Ulli2k/SmartCoffee/docs/NodeMCU-ESP8266-PINs-pinout.jpg

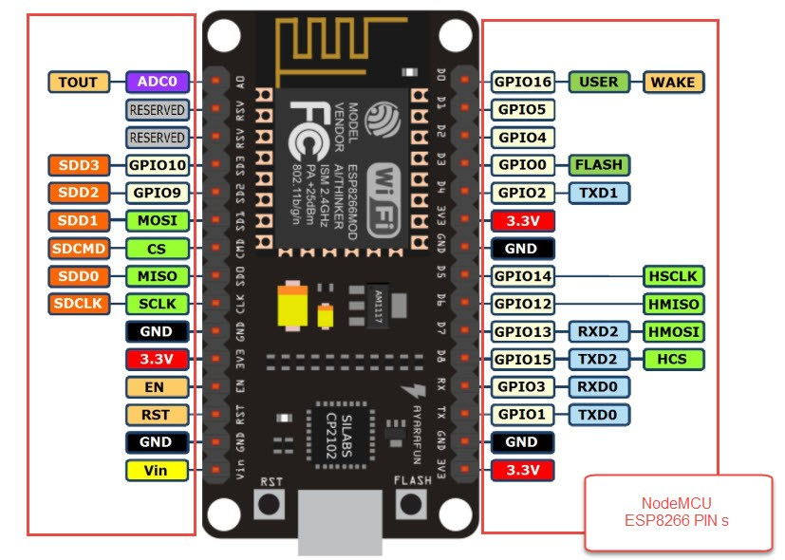
docs/NodeMCU-ESP8266-PINs-pinout.jpg
