Ulli2k/SmartCoffee/docs/Schaltplan-Silvia-E_PID.jpg

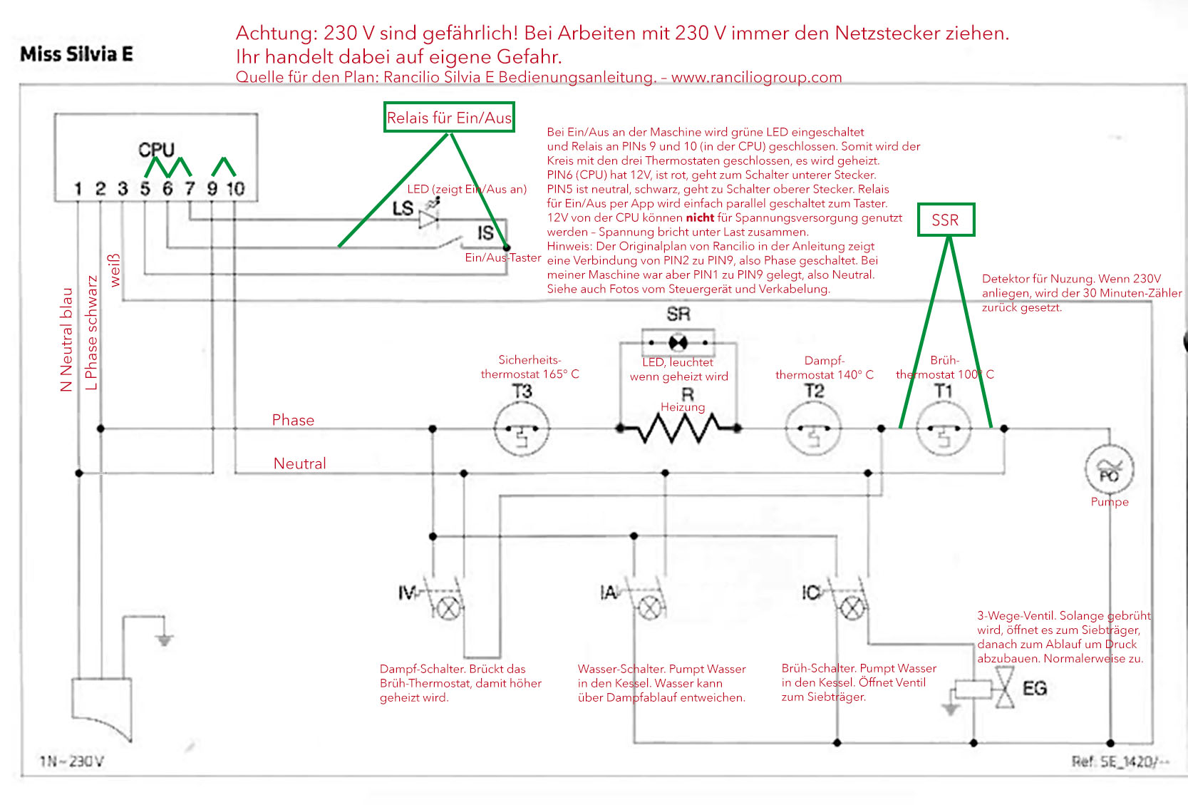
docs/Schaltplan-Silvia-E_PID.jpg
