Ulli2k/SmartCoffee/docs/BOM_SmartCoffee_reichelt.xlsx

BOM_SmartCoffee_reichelt
Part | Value | Device | Package | Description | REICHELT | LINK
C1 | 0.1µ | CAP0603-CAP | 0603-CAP | Capacitor | KEM Y5V0603 100N | https://www.reichelt.de/vielschicht-kerko-100nf-25v-85-c-kem-y5v0603-100n-p207005.html?&trstct=pol_1
C2 | 0.1µ | CAP0603-CAP | 0603-CAP | Capacitor | KEM Y5V0603 100N | https://www.reichelt.de/vielschicht-kerko-100nf-25v-85-c-kem-y5v0603-100n-p207005.html?&trstct=pol_1
C3 | 4.7µ | CAP0805-CAP | 0805-CAP | Capacitor | KEM X5R0603 4,7U | https://www.reichelt.de/vielschicht-kerko-4-7-f-10v-85-c-kem-x5r0603-4-7u-p207009.html?&trstct=pol_0
C4 | 0.1µ | CAP0603-CAP | 0603-CAP | Capacitor | KEM Y5V0603 100N | https://www.reichelt.de/vielschicht-kerko-100nf-25v-85-c-kem-y5v0603-100n-p207005.html?&trstct=pol_1
C5 | 0.1µ | CAP0603-CAP | 0603-CAP | Capacitor | KEM Y5V0603 100N | https://www.reichelt.de/vielschicht-kerko-100nf-25v-85-c-kem-y5v0603-100n-p207005.html?&trstct=pol_1
C6 | 0.1µ | CAP0603-CAP | 0603-CAP | Capacitor | KEM Y5V0603 100N | https://www.reichelt.de/vielschicht-kerko-100nf-25v-85-c-kem-y5v0603-100n-p207005.html?&trstct=pol_1
D1 | 1N4148W | DIODE-SOD123 | SOD123 | DIODE | RND 1N4148W | https://www.reichelt.de/schalt-diode-75-v-150-ma-sod-123-rnd-1n4148w-p223369.html
DISPLAY/ROTARY2 | PSS254_8GERADE | PSS254_8GERADE | 08G |  | PSS 254/8G | https://www.reichelt.de/printstecker-einzelstecker-gerade-8-polig-pss-254-8g-p14913.html
DS18B20 |  | PSS254_3GERADE | 03G |  | PSS 254/3G | https://www.reichelt.de/printstecker-einzelstecker-gerade-3-polig-pss-254-3g-p14462.html?trstct=pos_0
HEATER-SSR |  | PSS254_2GERADE | 02G |  | PSS 254/2G | https://www.reichelt.de/printstecker-einzelstecker-gerade-2-polig-pss-254-2g-p14907.html
HV_SUPPLY | 250-206 | 250-206 | P-250-206 | Serie 250, 1-Leiter-Klemmenleiste für Leiterplatten 1 Lötstift/Pol versetzt / Series 250, 1-conductor PCB terminal strip 1 solder pin/pole, staggeredPolzahl / Pole No.: 6 Rastermaß / Pitch: 3.5 - 3.5 mmBemessungsspannung / Rated Voltage: 320 VNennstrom / Nominal Current: 8 ALeiterquerschnitt / Conductor Size: 0.2 - 1.5 mm2Anschlusstechnik / Connection Technology: CAGE CLAMP® S Lötstiftlänge: / Solder Pin Length: 3.6 mmLeitereinführung (zur Platine) / Conductor entry angle (to PCB): 45 °Farbe / Color: grau / gray Stand: 01.01.2014. Die jeweils aktuellen Daten zu diesem Artikel finden Sie in unserem Produktkatalog, den Sie unter www.wago.com einsehen können. As of: 01/01/2014. Please find the newest data for this article in our product catalogue, which can be viewed under www.wago.com. | WAGO 250-206 | https://www.reichelt.de/klemmleiste-mit-betaetigungsdrueckern-rm-3-5-mm-8a-6-pol-wago-250-206-p100836.html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
IC1 | ULN2003V12DR | ULN2003AD | SO16 | DRIVER ARRAY | ULN 2003 AD SMD | https://www.reichelt.de/seven-darlington-arrays-so-16-uln-2003-ad-smd-p18887.html
K1 | G2R | G2RL-1 DC5 | G2R | RELAY | G2RL-1 DC5 | https://www.reichelt.de/leistungsrelais-tht-5-vdc-12a-1-wechsler-g2rl-1-dc5-p243108.html?trstct=pos_0
LED |  | PSS254_2GERADE | 02G |  | PSS 254/2G | https://www.reichelt.de/printstecker-einzelstecker-gerade-2-polig-pss-254-2g-p14907.html
LV_SUPPLY |  | PSS254_2GERADE | 02G |  | PSS 254/2G | https://www.reichelt.de/printstecker-einzelstecker-gerade-2-polig-pss-254-2g-p14907.html
OK1 | SFH620A | SFH620A | DIL04 | Optocoupler, Phototransistor Output, AC Input | SFH 620A-3 | https://www.reichelt.de/optokoppler-sfh-620a-3-p76195.html
ONOFF |  | PSS254_2GERADE | 02G |  | PSS 254/2G | https://www.reichelt.de/printstecker-einzelstecker-gerade-2-polig-pss-254-2g-p14907.html
PIEZO | BUZZER-PIEZO_SMD | BUZZER-PIEZO_SMD | BUZZER-PIEZO_SMD | Piezoelectric Acoustic Transducer
R1 | 4k7 | RESISTOR0603-RES | 0603-RES | Resistor | RND 1550603 BS | https://www.reichelt.de/smd-widerstand-0603-4-7-kohm-100-mw-5-rnd-1550603-bs-p250170.html?trstct=pol_2
R3 | 33 | RESISTOR0603-RES | 0603-RES | Resistor | RND 0603 1 33 | https://www.reichelt.de/smd-widerstand-0603-33-ohm-100-mw-1-rnd-0603-1-33-p183005.html?&trstct=pol_1
R4 | 22k | RESISTORUPRIGHT | RES_UPRIGHT | Resistor | 1W 22K | https://www.reichelt.de/widerstand-metalloxyd-22-kohm-0207-1-0-w-5-1w-22k-p1802.html?&trstct=pos_0
R5 | VARISTOR-S07K275 | VARISTOR-S07K275 | S07K275 | VARISTOR | VDR-0,25 420 | https://www.reichelt.de/varistor-rm-5mm-0-25w-420vac-vdr-0-25-420-p22313.html?&trstct=pol_0
R6 | 22k | RESISTORUPRIGHT | RES_UPRIGHT | Resistor | 1W 22K | https://www.reichelt.de/widerstand-metalloxyd-22-kohm-0207-1-0-w-5-1w-22k-p1802.html?&trstct=pos_0
R7 | 4k7 | RESISTOR0603-RES | 0603-RES | Resistor | RND 1550603 BS | https://www.reichelt.de/smd-widerstand-0603-4-7-kohm-100-mw-5-rnd-1550603-bs-p250170.html?trstct=pol_2
R8 | VARISTOR-S07K275 | VARISTOR-S07K275 | S07K275 | VARISTOR | VDR-0,25 420 | https://www.reichelt.de/varistor-rm-5mm-0-25w-420vac-vdr-0-25-420-p22313.html?&trstct=pol_0
R13 | 1k5 | RESISTOR0603-RES | 0603-RES | Resistor | RND 1550603 BM | https://www.reichelt.de/smd-widerstand-0603-1-5-kohm-100-mw-5-rnd-1550603-bm-p250164.html?trstct=pol_2
R16 | 1k5 | RESISTOR0603-RES | 0603-RES | Resistor | RND 1550603 BM | https://www.reichelt.de/smd-widerstand-0603-1-5-kohm-100-mw-5-rnd-1550603-bm-p250164.html?trstct=pol_2
R18 | 1k5 | RESISTOR0603-RES | 0603-RES | Resistor | RND 1550603 BM | https://www.reichelt.de/smd-widerstand-0603-1-5-kohm-100-mw-5-rnd-1550603-bm-p250164.html?trstct=pol_2
SUPPLY_SSR1 | OMRON-G3MB-202P-SSR | OMRON-G3MB-202P-SSR | OMRON-G3MB-202P-SSR | IT(rms) 8A, Zero Cross type SIP 4pin Triac output SSR
SUPPLY_SSR2 | OMRON-G3MB-202P-SSR | OMRON-G3MB-202P-SSR | OMRON-G3MB-202P-SSR | IT(rms) 8A, Zero Cross type SIP 4pin Triac output SSR
TSIC |  | PSS254_3GERADE | 03G |  | PSS 254/3G | https://www.reichelt.de/printstecker-einzelstecker-gerade-3-polig-pss-254-3g-p14462.html?trstct=pos_0
U$3 | ESP32DEVKITC | ESP32DEVKITC | ESP32-DEVKITC
