Ulli2k/SmartCoffee/docs/BOM.ods

PCB Klebepads
Silikonkabel oder PTFE Kabel für Temperatursensor |  |  | https://www.buerklin.com/de/Produkte/Kabel-und-Leitungen/Mehradrige-Kabel-und-Leitungen/Anschlussleitungen%2C-Steuerleitungen-und-Industrieleitungen/Anschluss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
TSIC306 – Temperatursensor |  |  | reichelt
OMRON SSR für Pumpe |  |  | 1 A instant-on type
OMRON SSR für 3 Wege Ventil
SENS für Pumpe (Optokoppler |  | SFH620A | Opto-isolated 48-240V~ sense input (zero crossing detection for phase angle control)
Kabel für Pumpe 1mm²
Signalkabel 0,25mm²
Leistungs SSR
Flachkontakte für Leistungsseite von SSR |  |  | 6.4mm Flachsteckhülsen (FASTON) terminals als Kabel?
Netzteil (230V, 5V mit >= 600mA) | Artikel-Nr.: SNT RS 15 5
Fuse ESKA t2A 250V
Wärmeleitpaste / Kleber
ONOFF Relais
Info
Vibrationspumpe (Wasser) |  | 230V, 50Hz, 48 W
 |  |  |  | 53D1659
Schaltersensor
Pro Platine | Reichelt
2 x 22KΩ 1W 1W 22K - Widerstand, Metalloxyd, 22 kOhm, 0207, 1,0 W, 5% (https://www.reichelt.de/widerstand-metalloxyd-22-kohm-0207-1-0-w-5-1w-22k-p1802.html?) | Artikel-Nr.: 1W 22K
1x SFH SFH 620A-3 - Optokoppler (https://www.reichelt.de/optokoppler-sfh-620a-3-p76195.html?) | Artikel-Nr.: SFH 620A-3
1x 4,7 oder 10µF RAD FC 4,7/50 - Elko radial, 4,7 uF, 50 V, 105°C, low ESR, AEC-Q200 (https://www.reichelt.de/elko-radial-4-7-uf-50-v-105-c-low-esr-aec-q200-rad-fc-4-7-50-p84583.html?) | RAD FC 4,7/50
1x 2KΩ Widerstand
1x Printstecker Gewinkelt PSS 254/3W - Printstecker, Einzelstecker, gewinkelt, 3-polig (https://www.reichelt.de/printstecker-einzelstecker-gewinkelt-3-polig-pss-254-3w-p14910.html?) | Artikel-Nr.: PSS 254/3W
ESP8266
GPIOs 4 and 5 are the only ones that are always high impedance. All others do have internal pull-ups or are even driven low/high during boot.
GPIOs 3, 12, 13 and 14 pulled HIGH during boot. Their actual state does not influence the boot process.
GPIOs 0, 1, 2 and 15 are pulled HIGH during boot and also driven LOW for short periods.
The device will not boot if 0, 1 or 2 is driven LOW during start-up.
GPIO 16 is driven HIGH during boot, don't short to GND.
