Ulli2k/SmartCoffee/hardware/SmartCoffee_InterfaceName.pdf

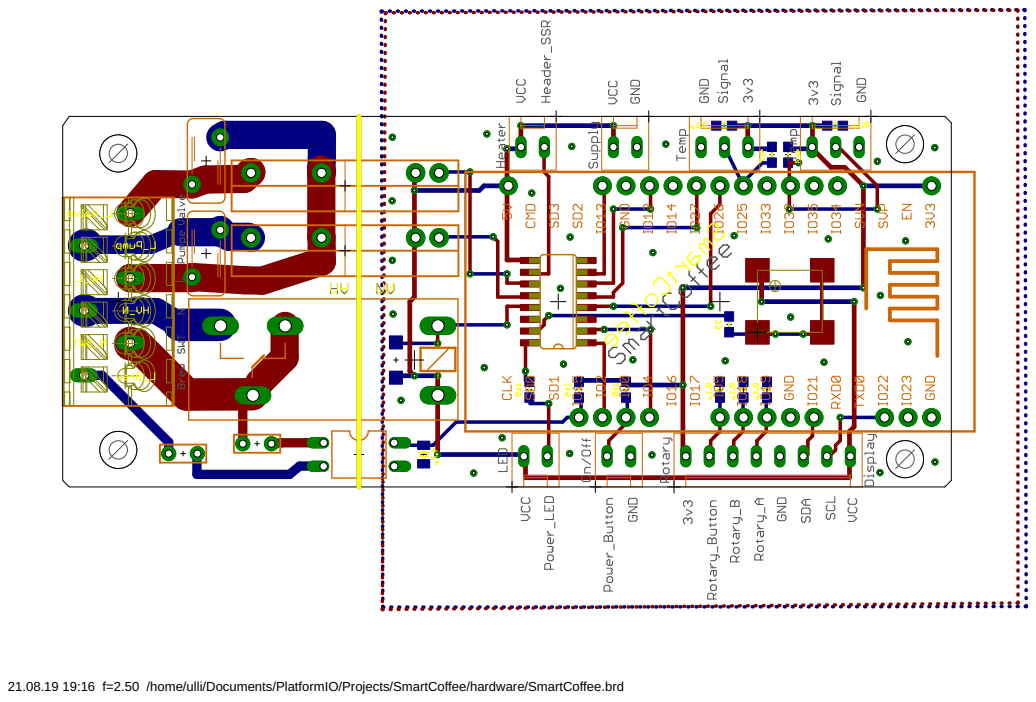
[picture p3: page 1]

21.08.19 19:16 f=2.50 /home/ulli/Documents/PlatformIO/Projects/SmartCoffee/hardware/SmartCoffee.brd
