Ulli2k/SmartCoffee/hardware/SmartCoffee.pdf

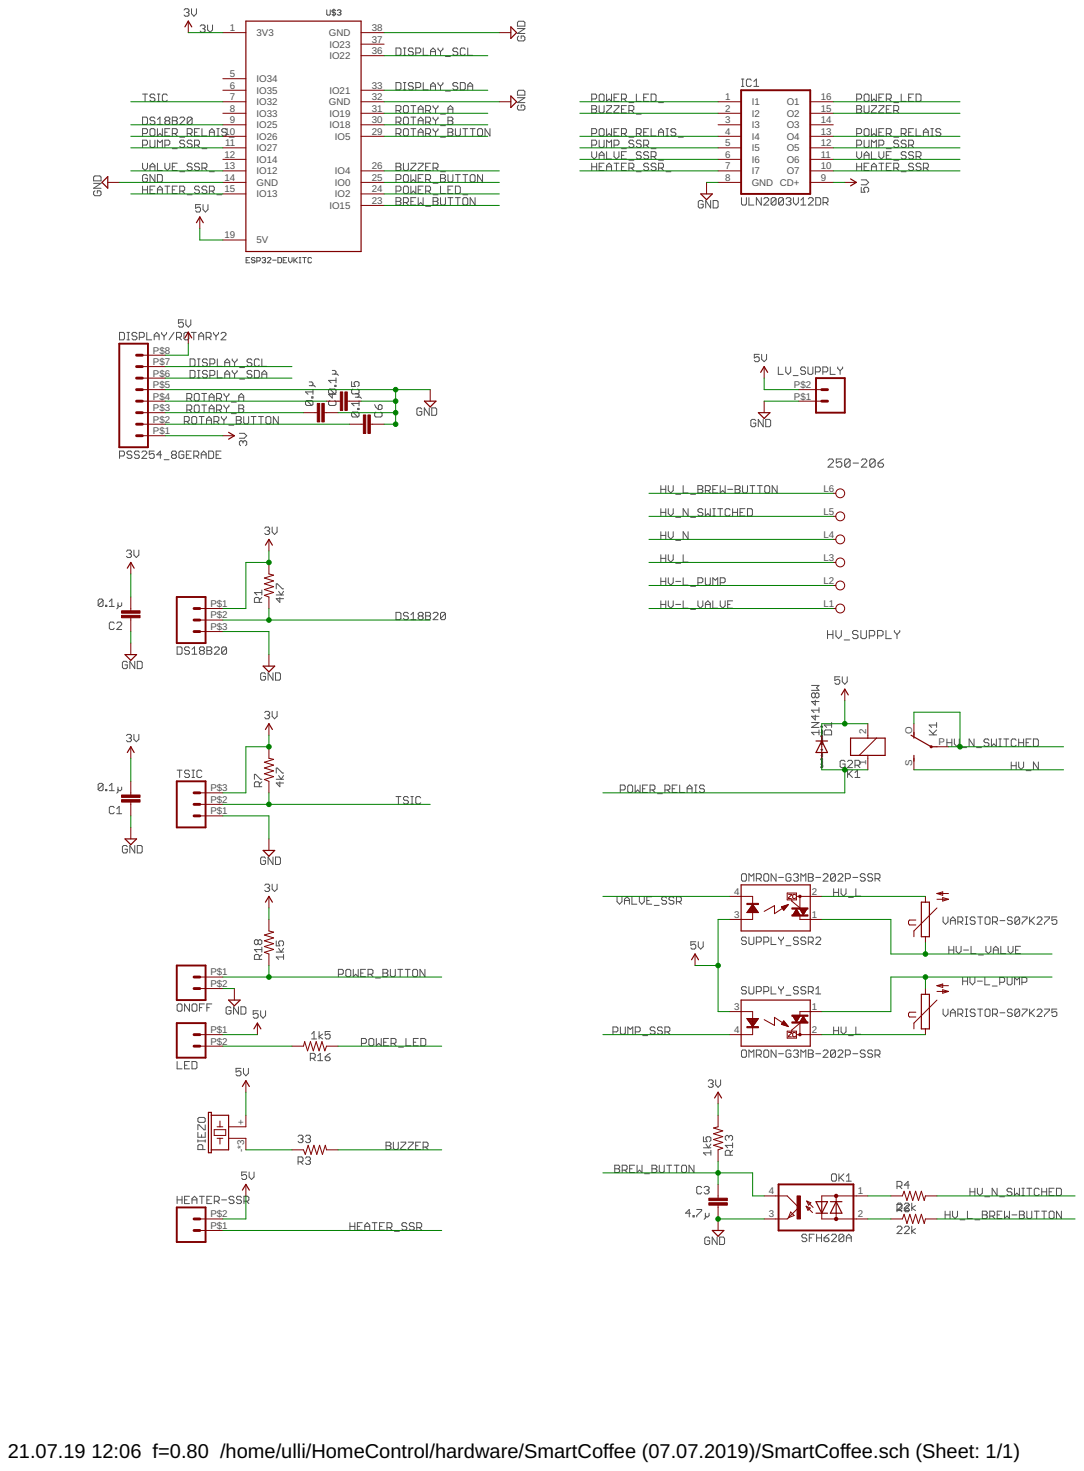
[picture p4: page 1]

21.07.19 12:06 f=0.80 /home/ulli/HomeControl/hardware/SmartCoffee (07.07.2019)/SmartCoffee.sch (Sheet: 1/1)
