Ulli2k/SmartCoffee/hardware/SmartCoffee.brd

## EAGLE design hardware/SmartCoffee.brd (2019-08-21)

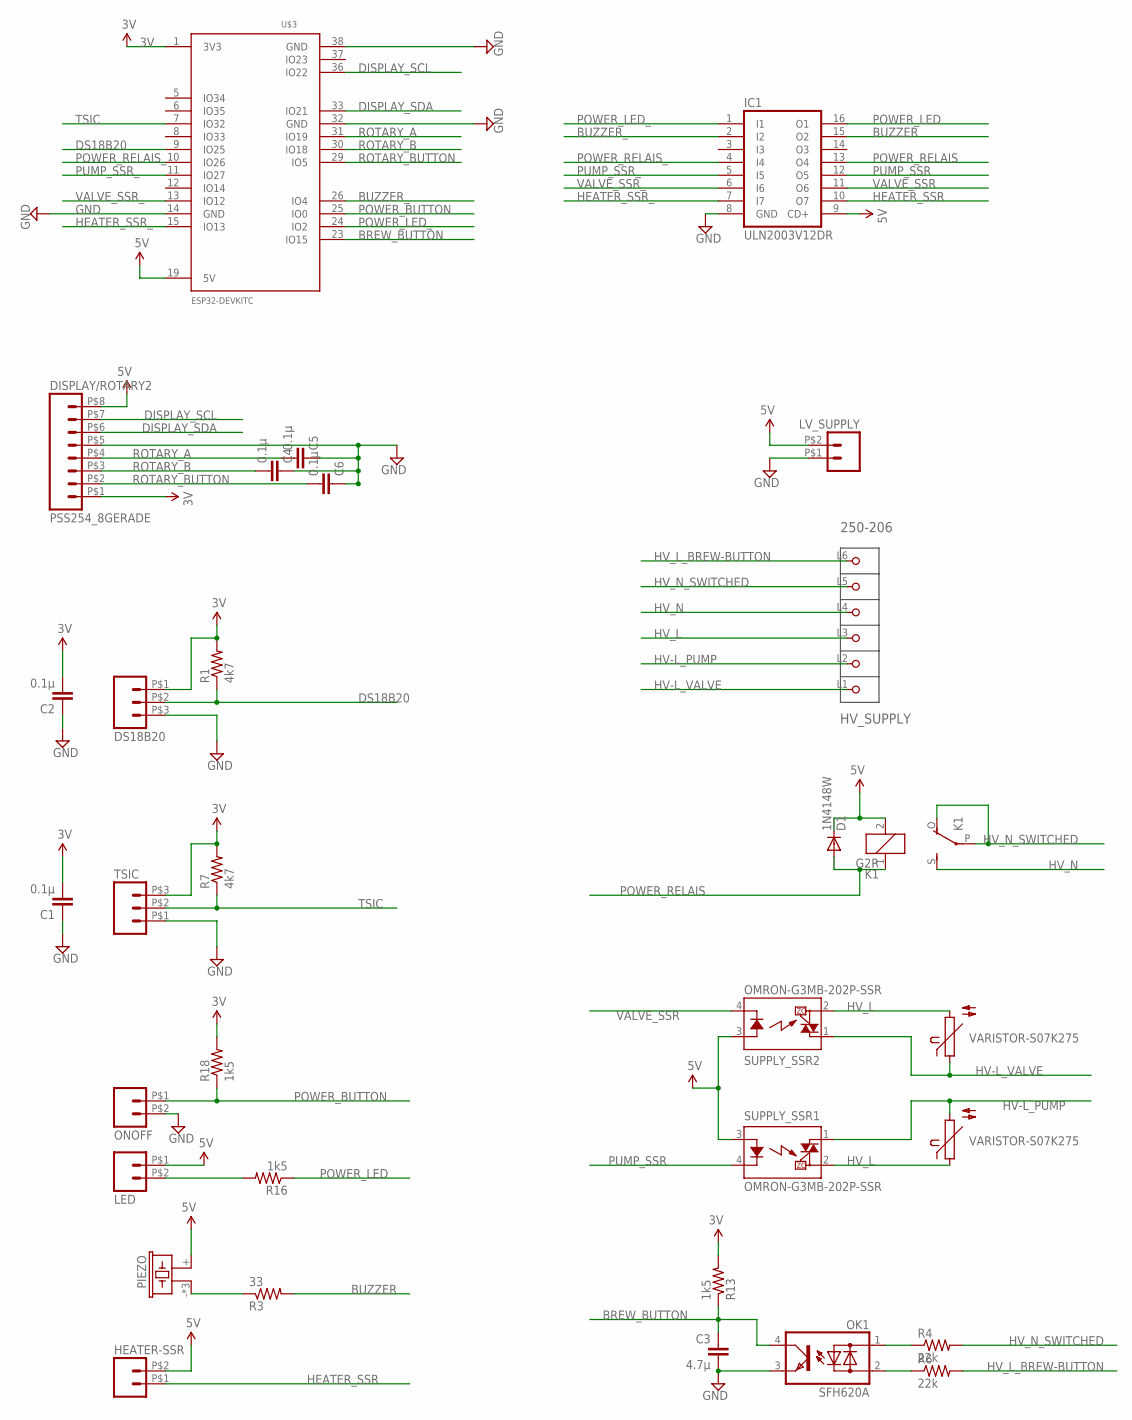
[picture p5: schematic SmartCoffee.sch]

Parts:
C1, C2, C4, C5, C6: 0.1µ; 0603-CAP
C3: 4.7µ; 0805-CAP
D1: 1N4148W; SOD123
DISPLAY/ROTARY2: PSS254_8GERADE; 08G
DS18B20: PSS254_3GERADE; 03G
HEATER-SSR: PSS254_2GERADE; 02G
HV_SUPPLY: 250-206; P-250-206
IC1: ULN2003V12DR; SO16
K1: G2R
LED: PSS254_2GERADE; 02G
LV_SUPPLY: PSS254_2GERADE; 02G
OK1: SFH620A; DIL04
ONOFF: PSS254_2GERADE; 02G
PIEZO: BUZZER-PIEZO_SMD
R1, R7: 4k7; 0603-RES
R3: 33; 0603-RES
R4, R6: 22k; RES_UPRIGHT
R5, R8: VARISTOR-S07K275; S07K275
R13, R16, R18: 1k5; 0603-RES
SUPPLY_SSR1, SUPPLY_SSR2: OMRON-G3MB-202P-SSR
TSIC: PSS254_3GERADE; 03G
U$3: ESP32DEVKITC; ESP32-DEVKITC

Connections:
3V: C1.2, C2.2, DISPLAY/ROTARY2.P$1 (1), DS18B20.P$1 (1), R1.2, R7.2, R13.2, R18.2, TSIC.P$3 (3), U$3.1 (3V3)
BREW_BUTTON: C3.1, OK1.4 (C), R13.1, U$3.23 (IO15)
BUZZER: IC1.15 (O2), R3.2
BUZZER_: IC1.2 (I2), U$3.26 (IO4)
DISPLAY_SCL: DISPLAY/ROTARY2.P$7 (7), U$3.36 (IO22)
DISPLAY_SDA: DISPLAY/ROTARY2.P$6 (6), U$3.33 (IO21)
DS18B20: DS18B20.P$2 (2), R1.1, U$3.9 (IO25)
GND: C1.1, C2.1, C3.2, C4.1, C5.1, C6.1, DISPLAY/ROTARY2.P$5 (5), DS18B20.P$3 (3), IC1.8 (GND), LV_SUPPLY.P$1 (1), OK1.3 (E), ONOFF.P$2 (2), TSIC.P$1 (1), U$3.14 (GND), U$3.32 (GND), U$3.38 (GND)
HEATER_SSR: HEATER-SSR.P$1 (1), IC1.10 (O7)
HEATER_SSR_: IC1.7 (I7), U$3.15 (IO13)
HV-L_PUMP: HV_SUPPLY.L2 (P2), R8.2, SUPPLY_SSR1.1 (DS1)
HV-L_VALVE: HV_SUPPLY.L1 (P1), R5.1, SUPPLY_SSR2.1 (DS1)
HV_L: HV_SUPPLY.L3 (P3), R5.2, R8.1, SUPPLY_SSR1.2 (DS2), SUPPLY_SSR2.2 (DS2)
HV_L_BREW-BUTTON: HV_SUPPLY.L6 (P6), R6.2
HV_N: HV_SUPPLY.L4 (P4), K1.S
HV_N_SWITCHED: HV_SUPPLY.L5 (P5), K1.O, K1.P, R4.2
unnamed: LED.P$2 (2), R16.2
unnamed: OK1.1 (AC1), R4.1
unnamed: PIEZO.- (2), PIEZO.DUMMY (2), PIEZO.DUMMY1 (2), R3.1
unnamed: OK1.2 (AC2), R6.1
POWER_BUTTON: ONOFF.P$1 (1), R18.1, U$3.25 (IO0)
POWER_LED: IC1.16 (O1), R16.1
POWER_LED_: IC1.1 (I1), U$3.24 (IO2)
POWER_RELAIS: D1.A, IC1.13 (O4), K1.1
POWER_RELAIS_: IC1.4 (I4), U$3.10 (IO26)
PUMP_SSR: IC1.12 (O5), SUPPLY_SSR1.4 (K)
PUMP_SSR_: IC1.5 (I5), U$3.11 (IO27)
ROTARY_A: C5.2, DISPLAY/ROTARY2.P$4 (4), U$3.31 (IO19)
ROTARY_B: C4.2, DISPLAY/ROTARY2.P$3 (3), U$3.30 (IO18)
ROTARY_BUTTON: C6.2, DISPLAY/ROTARY2.P$2 (2), U$3.29 (IO5)
TSIC: R7.1, TSIC.P$2 (2), U$3.7 (IO32)
VALVE_SSR: IC1.11 (O6), SUPPLY_SSR2.4 (K)
VALVE_SSR_: IC1.6 (I6), U$3.13 (IO12)
VCC: D1.C, DISPLAY/ROTARY2.P$8 (8), HEATER-SSR.P$2 (2), IC1.9 (CD+), K1.2, LED.P$1 (1), LV_SUPPLY.P$2 (2), PIEZO.+ (1), SUPPLY_SSR1.3 (A), SUPPLY_SSR2.3 (A), U$3.19 (5V)

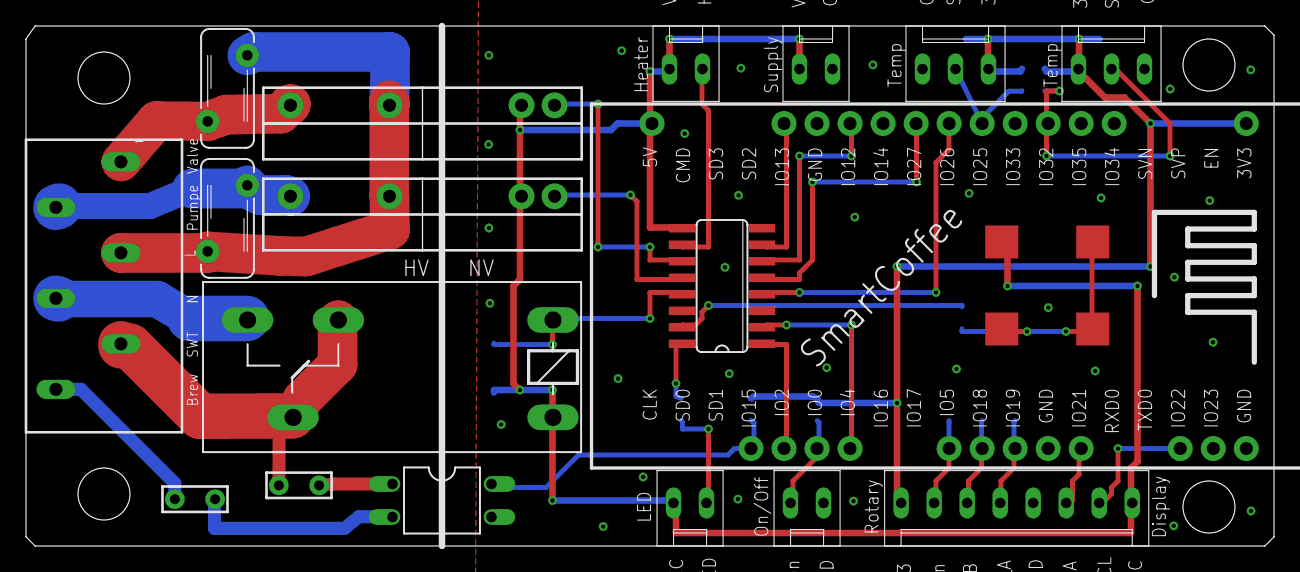
[picture p6: board SmartCoffee.brd from above]

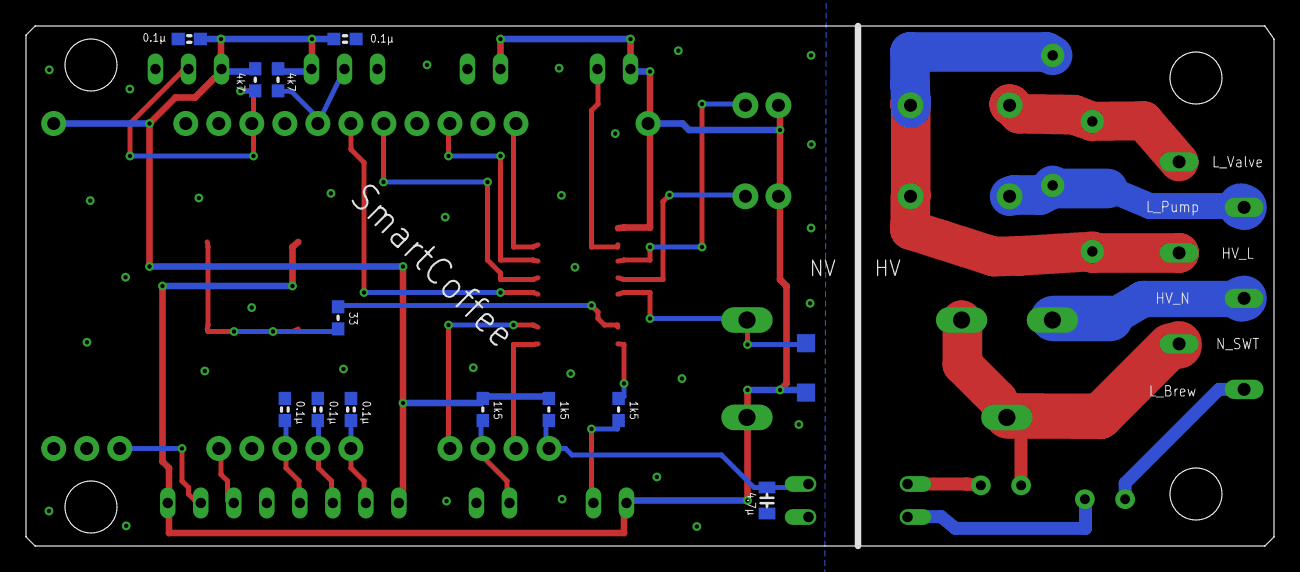
[picture p7: board SmartCoffee.brd from below]

Board: 2 copper layers, 96.0 x 40.0 mm, 32 parts (13 on the bottom side), 34 nets.
