Ulli2k/SmartCoffee/include/interface.h

#ifndef __MENU_H__
#define __MENU_H__

#ifdef HAS_INTERFACE

#include <globals.h>
#include <encoder.h>
#include <display.h>

#include <menu.h>//menu macros and objects
#include <menuIO/u8g2Out.h>
#include <menuIO/clickEncoderIn.h>
#include <menuIO/chainStream.h>

namespace UserInterface {
  using namespace Menu;

  result cleaning(eventMask e,navNode& nav, prompt &item);
  result exitMenu(eventMask e, navNode& nav, prompt &item);

  // ------------------- MENU ----------------------
  #define MAX_DEPTH 2

  const colorDef<uint8_t> colors[] MEMMODE={ //  {{disabled normal,disabled selected},{enabled normal,enabled selected, enabled editing}}
    {{0,0},{0,1,0}},//bgColor
    {{0,0},{1,1,1}},//fgColor
    {{1,1},{1,0,0}},//valColor
    {{1,1},{1,0,0}},//unitColor
    {{0,0},{0,0,1}},//cursorColor
    {{1,1},{1,0,0}},//titleColor
    // {{0,0},{0,1,1}},//bgColor
    // {{1,1},{1,0,0}},//fgColor
    // {{1,1},{1,0,0}},//valColor
    // {{1,1},{1,0,0}},//unitColor
    // {{0,1},{0,0,1}},//cursorColor
    // {{1,1},{1,0,0}},//titleColor
  };

  MENU(subMenu_TempCtl,"TempControl    ",doNothing,anyEvent,noStyle
    ,FIELD(globalValues.TempSetValue,                     "Temperature ","C",0,100,1,0,doNothing,noEvent,wrapStyle)
    ,FIELD(configValues.stateMaschine.TempMinError,       "TempThreshold  ","C",0,20,1,0,doNothing,noEvent,wrapStyle)
    ,FIELD(configValues.stateMaschine.TempStabilizingTime,"TempStabilize ","s",0,200,1,0,doNothing,noEvent,wrapStyle)
    ,FIELD(configValues.PID.consKp,                       "Kp         "," ",0,300,1,1,doNothing,noEvent,wrapStyle)
    ,FIELD(configValues.PID.consKi,                       "Ki          "," ",0,10,0.1,0.01,doNothing,noEvent,wrapStyle)
    ,FIELD(configValues.PID.consKd,                       "Kd          "," ",0,10,0.1,0.01,doNothing,noEvent,wrapStyle)
    ,FIELD(configValues.PID.Gap4BoostParameter,           "boostGap      "," ",0,50,1,1,doNothing,noEvent,wrapStyle)
    ,FIELD(configValues.PID.boostKp,                      "boostKp   "," ",0,300,1,1,doNothing,noEvent,wrapStyle)
    ,FIELD(configValues.PID.boostKi,                      "boostKi     "," ",0,10,0.1,0.01,doNothing,noEvent,wrapStyle)
    ,FIELD(configValues.PID.boostKd,                      "boostKd     "," ",0,10,0.1,0.01,doNothing,noEvent,wrapStyle)
    ,EXIT("<Back")
  );

  MENU(subMenu_Preinfusion,"Preinfusion    ",doNothing,anyEvent,noStyle
    ,FIELD(configValues.stateMaschine.Preinfusion_Duration,     "Preinfusion ","s",0,60,1,0.1,doNothing,noEvent,wrapStyle)
    ,FIELD(configValues.stateMaschine.Preinfusion_PumpDuration, "Preinf.Pump ","s",0,10,1,0.1,doNothing,noEvent,wrapStyle)
    ,EXIT("<Back")
  );

  MENU(subMenu_Brewing,"Brewing        ",doNothing,anyEvent,noStyle
    ,FIELD(configValues.stateMaschine.Brewing_Duration,             "Brewing    ","s",0,60,1,0.1,doNothing,noEvent,wrapStyle)
    ,FIELD(configValues.stateMaschine.BrewingTempSetpointIncrease,  "BrewingInc    ","C",0,100,1,0,doNothing,noEvent,wrapStyle)
    ,FIELD(configValues.stateMaschine.Flush_Duration,               "Flush       ","s",0,20,1,0.1,doNothing,noEvent,wrapStyle)
    ,EXIT("<Back")
  );

  MENU(subMenu_Cleaning,"Cleaning       ",doNothing,anyEvent,noStyle
    ,OP("Start Cleaning ",cleaning,enterEvent)
    ,FIELD(configValues.stateMaschine.Cleaning_WaitDuration,  "CleanWait  ","s",1,120,1,0,doNothing,noEvent,wrapStyle)
    ,FIELD(configValues.stateMaschine.Cleaning_FlushDuration, "CleanFlush  ","s",1,10,1,0.1,doNothing,noEvent,wrapStyle)
    ,FIELD(configValues.stateMaschine.Cleaning_NumFlushes,    "CleanFlushNum  ","",1,10,1,0,doNothing,noEvent,wrapStyle)
    ,EXIT("<Back")
  );

  MENU(mainMenu,"Configuration",doNothing,noEvent,noStyle
    ,SUBMENU(subMenu_TempCtl)
    ,SUBMENU(subMenu_Preinfusion)
    ,SUBMENU(subMenu_Brewing)
    ,SUBMENU(subMenu_Cleaning)
    ,FIELD(configValues.stateMaschine.MaxPowerOnTime, "MaxPowerOn  ","min",1,120,10,5,doNothing,noEvent,wrapStyle)
    ,OP("reboot         ",rebootESP,enterEvent)
    ,OP("save config    ",saveConfiguration,enterEvent)
    ,OP("reset config   ",removeConfiguration,enterEvent)
    ,OP("<Back          ", exitMenu,enterEvent)
  );

  ClickEncoderStream encStream(cEncoder.encoder,1);
  MENU_INPUTS(in,&encStream);
  MENU_OUTPUTS(out,MAX_DEPTH
    // ,U8X8_OUT(u8x8,{0,1,10,6})
    ,U8G2_OUT(cDisplay.u8g2,colors,cDisplay.fontX,cDisplay.fontY, 0, /* Headersize*/ 2 /*cDisplay.fontY+3*/ ,{0,1,cDisplay.width/cDisplay.fontX,cDisplay.height/cDisplay.fontY-1})
    ,NONE
  );
  NAVROOT(nav,mainMenu,MAX_DEPTH,in,out);//the navigation root object


/****************************************** Interface Class ******************************************/

  #define DRAW(CMD) { cDisplay.firstPage(); do { CMD; } while(cDisplay.nextPage()); }

  #define GET_CENTER_POSITION_X(STR) ((cDisplay.width-cDisplay.u8g2.getStrWidth(STR))/2)
  #define GET_FONT_WIDTH(STR)        (cDisplay.u8g2.getStrWidth(STR))

  enum InterfaceScreen {
    CONFIG=0,
    STANDBY,
    TEXT,
    VALUE
  };

// #define convertEvents(label) (InterfaceEvent::#label);

  typedef struct {
    char header[20];
    double *value;
    char text[20];
    char valueUnit[5];
    double *setpoint;
    double *percent;
    bool setpointEditMode;

  } draw_ScreenValues;

  class ScreenTypes {

  private:

    void drawHeader(char *name) {
      cDisplay.setFontSize();
      cDisplay.u8g2.drawStr(0,cDisplay.fontY, name);
      cDisplay.u8g2.drawHLine(0,cDisplay.fontY+1,128);
    }

    void drawSetPoint(double *setpoint, bool *editMode) {
      if(!setpoint) return;
      cDisplay.setFontSize();
      char str[6];
      uint8_t i = (uint8_t)(*setpoint);
      if(editMode != NULL && *editMode) {
        sprintf(str, (i>9 ? ">%d" : "> %d"), i);
      } else {
        sprintf(str, (i>9 ? "%d" : " %d"), i);
      }
      cDisplay.u8g2.drawStr(cDisplay.width-GET_FONT_WIDTH(str) , cDisplay.fontY, str);
    }

    void drawProgressBar(double *percent, uint8_t x, uint8_t y, uint8_t h) {
      if(!percent) return;
      cDisplay.setFontSize();
      cDisplay.u8g2.drawFrame(x, y, cDisplay.width-(x*2), h); \
      cDisplay.u8g2.drawBox(x+2, y+2, (uint8_t)((cDisplay.width-(x*2)-4) * (*percent)), h-4);
    }

    void drawMainValue(double *value, char *unit, uint8_t y) {
      if(!value) return;
      cDisplay.setFontSize();
      char str[5];
      uint8_t u = 0;
      if(unit) u = GET_FONT_WIDTH(unit);
      cDisplay.setFontSize(3);
      uint8_t v = (uint8_t)(*value);
      sprintf(str, (v>9 ? "%d" : " %d"), v);
      v = GET_FONT_WIDTH(str);
      v += 2; //Abstand
      cDisplay.u8g2.drawStr( (cDisplay.width-(u+v))/2 , y, str);
      if(unit) {
        cDisplay.setFontSize();
        cDisplay.u8g2.drawStr( (cDisplay.width-(u+v))/2+v/*Abstand*/ , y, unit);
      }
    }

    void drawMainText(char *text, uint8_t y) {
      cDisplay.setFontSize(3);
      uint8_t v = GET_FONT_WIDTH(text);
      cDisplay.u8g2.drawStr( (cDisplay.width-(v))/2 , y, text);
    }

    void drawText(char *text, uint8_t y) {
      cDisplay.setFontSize();
      uint8_t v = GET_FONT_WIDTH(text);
      cDisplay.u8g2.drawStr( (cDisplay.width-(v))/2 , y, text);
    }

  public:
    draw_ScreenValues drawValues;

    ScreenTypes() { clear(); }

    void clear() {
      drawValues.header[0]        = 0x0;
      drawValues.value            = NULL;
      drawValues.text[0]          = 0x0;
      drawValues.valueUnit[0]     = 0x0;
      drawValues.setpoint         = NULL;
      drawValues.setpointEditMode = false;
      drawValues.percent          = NULL;
      // drawValues.lastUpdate       = 0;
      // drawValues.UpdateInterval   = DEFAULT_UPDATE_INTERVAL;
    }

    void drawTextScreen() {
      if(!drawValues.header[0]) return;
      drawHeader(drawValues.header);

      drawText(drawValues.text, cDisplay.height - 17);
    }

    void drawValueScreen() {
      
      if(!drawValues.header[0]) return;
      drawHeader(drawValues.header);

      drawSetPoint(drawValues.setpoint, &drawValues.setpointEditMode);

      drawProgressBar(drawValues.percent,0,cDisplay.height-10,10);

      drawMainValue(drawValues.value, drawValues.valueUnit, cDisplay.height - 17);

    }

    void drawConfigScreen() {
      drawHeader("Configuration");
      nav.doOutput();
    }

    void drawDateTimeScreen() {
      char buffer[12]; //dd.mm.yyyy & hh:mm
      const char *days[] = {"So", "Mo", "Di", "Mi", "Do", "Fr", "Sa"};

      drawHeader(drawValues.header);

      sprintf(buffer,"%.2d:%.2d",globalValues.TimeDate.hour, globalValues.TimeDate.min);
      drawMainText(buffer,cDisplay.height-17);

      sprintf(buffer,"%s, %.2d.%.2d",days[globalValues.TimeDate.wday], globalValues.TimeDate.day,globalValues.TimeDate.month);
      drawText(buffer,cDisplay.height);

      globalValues.TimeDate.updated = false;
    }
  };

  class ClassMenu : public ScreenTypes {

  private:
    InterfaceScreen screen;

  public:
	  ClassMenu()  {}
    static MenuFunctions ConfigMenuFkt;
    static bool forceUpdateScreen;

  	void initialize() {
      cDisplay.initialize();
      activateTextScreen("Servus!","booting...");flush();
      cEncoder.initialize();

      // nav.idleTask=idle;//point a function to be used when menu is suspended
      // mainMenu[1].enabled=disabledStatus;
      nav.showTitle=false;
      // nav.idleTask=idle;//point a function to be used when menu is suspended
      screen = CONFIG;
      forceUpdateScreen = true;
      ConfigMenuFkt = NOTHING;
    }

    void flush() {
      switch(screen) {
        case CONFIG:
          if (nav.changed(0) || forceUpdateScreen) {//only draw if menu changed for gfx device
            //change checking leaves more time for other tasks
            DRAW( drawConfigScreen(); )
          }
        break;

        case STANDBY:
          if(globalValues.TimeDate.updated || forceUpdateScreen) {
            DRAW( drawDateTimeScreen(); )
          }
        break;

        case TEXT:
          DRAW( drawTextScreen(); )
        break;

        case VALUE:
          DRAW( drawValueScreen(); )
        break;
      }
    }

    MenuFunctions getMenuFunction(EncoderEvent EncRetVal) {
      switch(EncRetVal) {
        case ENC_NOTHING:
          return NOTHING;
        case ENC_BUTTON_PRESSED:
          return BUTTON_PRESSED;
        case ENC_BUTTON_HELD:
          return BUTTON_HELD;
        case ENC_ROTATE_LEFT:
          return ROTATE_LEFT;
        case ENC_ROTATE_RIGHT:
          return ROTATE_RIGHT;
        }
        return NOTHING;
    }

    enum MenuFunctions poll() {

      MenuFunctions retVal = NOTHING;

      if(ConfigMenuFkt) {
        retVal = ConfigMenuFkt;
        ConfigMenuFkt = NOTHING;
        return retVal;
      }

      switch(screen) {
        case CONFIG:
          nav.doInput();
          break;

        case STANDBY:
          // break;
        case TEXT:
          retVal = getMenuFunction(cEncoder.poll());
          if(retVal == BUTTON_HELD) {
            activateConfigScreen();
            return BUTTON_HELD;
          }
          break;

        case VALUE:
          if(retVal = getMenuFunction(cEncoder.poll())) {
            if(retVal == BUTTON_HELD) {
              activateConfigScreen();
              return BUTTON_HELD;
            }
            if(drawValues.setpoint) {
              switch(retVal) {
                case BUTTON_PRESSED:
                  drawValues.setpointEditMode = !drawValues.setpointEditMode;
                  break;
                case ROTATE_LEFT:
                  if(drawValues.setpointEditMode)
                    (*drawValues.setpoint)++;
                  break;
                case ROTATE_RIGHT:
                  if(drawValues.setpointEditMode)
                    (*drawValues.setpoint)--;
                  break;
              }
            }
            return retVal;
          }
          break;
      }

      flush();

      if(retVal != NOTHING) forceUpdateScreen = false;
      return retVal;
    }

    void changeScreen(InterfaceScreen s) {
      screen = s;
      forceUpdateScreen = true;
    }

    void activateTextScreen(const char* header, const char *text) {
      clear();
      strcpy(drawValues.header,header);
      strcpy(drawValues.text,text);
      changeScreen(TEXT);
    }

    void activateValueScreen(const char* header, double *value = NULL, const char *unit = NULL, double *setpoint = NULL, double *percent = NULL) {
      clear();
      strcpy(drawValues.header,header);
      drawValues.value = value;
      if(unit) {
        strcpy(drawValues.valueUnit,unit);
      }
      drawValues.setpoint = setpoint;
      drawValues.percent = percent;
      changeScreen(VALUE);
    }

    void activateConfigScreen() {
      changeScreen(CONFIG);
    }

    void activateStandbyScreen(const char* header) {
      clear();
      strcpy(drawValues.header,header);
      changeScreen(STANDBY);
    }
  };


  result showEvent(eventMask e,navNode& nav,prompt& item) {
    Serial.print("event: ");
    Serial.println(e);
    return proceed;
  }

  result cleaning(eventMask e, navNode& nav, prompt &item) {
    ClassMenu::ConfigMenuFkt = FKT_CLEANING;
    return proceed;
  }

  result exitMenu(eventMask e, navNode& nav, prompt &item) {
    ClassMenu::ConfigMenuFkt = EXIT;
    ClassMenu::forceUpdateScreen = true;
    return proceed;
  }

  MenuFunctions ClassMenu::ConfigMenuFkt = NOTHING; //static variable
  bool ClassMenu::forceUpdateScreen = true;
}

#else

#include <encoder.h>

namespace UserInterface {

class noClassMenu {
public:
  void initialize() { }
  enum EncoderEvent poll() {}
  void flush() {}
  void activateTextScreen(const char* header, char *text) { }
  void activateValueScreen(const char* header, double *value = NULL, const char *unit = NULL, double *setpoint = NULL, double *percent = NULL) { }
  void activateConfigScreen() {}
};
}

#endif

#endif
