Ulli2k/SmartCoffee/include/globals.h

#ifndef __GLOBALS_H__
#define __GLOBALS_H__

//==============================================================
//                  Global Values
//==============================================================

enum MenuFunctions {
  NOTHING = 0,
  BUTTON_PRESSED,
  BUTTON_HELD,
  ROTATE_LEFT,
  ROTATE_RIGHT,
  FKT_CLEANING,
  EXIT
};

struct structGlobalValues{
  bool standby;
  double TempSetValue; //PID SetPoint
  // bool   SetPointEditMode;
  // bool PIDactive;
  double TempValue;    //PID Input
  double Pid_Percent;  //PID OutPut in percent
  struct {
    uint8_t hour;
    uint8_t min;
    uint8_t wday;
    uint8_t day;
    uint8_t month;
    bool updated;
  } TimeDate;
} globalValues;

#define EEPROM_KEY    945487320 //4 bytes
struct structConfigValues {
  unsigned int key;
  double TempSetValue; //PID SetPoint

  struct {
    double  consKp;
    double  consKi;
    double  consKd;
    uint8_t Gap4BoostParameter;
    double  boostKp;
    double  boostKi;
    double  boostKd;
  } PID;

  struct {
    uint8_t   MaxPowerOnTime;
    uint8_t   TempMinError;
    uint8_t   TempStabilizingTime;
    double    Preinfusion_Duration;
    double    Preinfusion_PumpDuration;
    double    Brewing_Duration;
    uint8_t   BrewingTempSetpointIncrease;
    double    Flush_Duration;
    double    Cleaning_WaitDuration;
    double    Cleaning_FlushDuration;
    uint8_t   Cleaning_NumFlushes;
  } stateMaschine;

} configValues;

// extern String getValueForInterface  (String name);
extern void   setValueByInterface   (String name, String value);
extern void   pushValueToInterface (String name, String value);

#ifdef ESP32
#define EEPROM_SIZE     1024

void getConfiguration() {

  structConfigValues buffer;

  EEPROM.begin(EEPROM_SIZE);
  EEPROM.get( 0, buffer);

  if(buffer.key == EEPROM_KEY) {
    memcpy(&configValues, &buffer, sizeof(structConfigValues));
    Serial.print("Configuration loaded from EEPROM. (");Serial.print(configValues.key); Serial.println(")");

  } else {  // Use Default Values
    Serial.print("Default configuration is used. (");Serial.print(configValues.key); Serial.println(")");
  }

  globalValues.TempValue        = configValues.TempSetValue; //&Pid_Input;
  globalValues.Pid_Percent      = 0; //&Pid_Percent;
}

void rebootESP() {
  ESP.restart();
}

void saveConfiguration() {

  configValues.key        = EEPROM_KEY;
  if(globalValues.TempSetValue > 0.1) {
    configValues.TempSetValue  = globalValues.TempSetValue;
  }

  EEPROM.put(0, configValues);
  EEPROM.commit();
  Serial.print("Configuration safed (");Serial.print(configValues.key); Serial.println(")");
}

void removeConfiguration() {
  configValues.key = 0;
  EEPROM.put(0, configValues);
  EEPROM.commit();
  rebootESP();
}

#else
  void getConfiguration() {}
  void saveConfiguration() {}
  void removeConfiguration() {}
#endif

#endif
