Ulli2k/SmartCoffee/(commit log)

2019-08-06 Interface deaktivierbar. WLAN reconnect fix.
    [display.h, globals.h, interface.h, main.cpp, statemachine.h, tempSens.h, web.h]
2019-08-07 Erhöhung Genauigkeit des Timers. s->ms Bugfix, so das Bezug abgebrochen werden kann.
    [globals.h, interface.h, statemachine.h]
2019-08-08 Parameteranpassung. Temp sStabelizing fix. OTA fix
    [statemachine.h]
2019-08-15 Clock im Standbymodus ergänzt Flush Funktion auf Button gelegt
2019-08-15 Cleaning Fix & Menu neu sortiert
    [interface.h, statemachine.h]
2019-08-15 BOM Reichelt
    [BOM_SmartCoffee_reichelt.xlsx]
2019-08-17 Add Auto Turn off timer Cleanup Menu. Flush before first cup
2019-08-20 Date BugFix, Erweiterung um PowerOn Push Nachricht an FHEM
    [globals.h, main.cpp, statemachine.h, web.h, web_server.h]
2019-08-21 Upload Interface description
    [SmartCoffee.brd]
2019-09-08 Debounce Power Button
